ntogou/nova-v2/firmware/nova_live/config.h

#pragma once
#define FW_VERSION "2.9.0"
#define UI_ENGLISH 1
#define UI_TR(tr, en) (UI_ENGLISH ? (en) : (tr))
#define PIN_AMP_R_BCLK 42
#define PIN_AMP_R_LRC   2
#define PIN_AMP_R_DIN  41
#define PIN_AMP_L_BCLK 10
#define PIN_AMP_L_LRC  11
#define PIN_AMP_L_DIN   9
#define PIN_MIC_SCK    12
#define PIN_MIC_WS     13
#define PIN_MIC_SD     14
#define PIN_TFT_BLK     4
#define PIN_TFT_CS      5
#define PIN_TFT_DC      6
#define PIN_TFT_RST     7
#define PIN_TFT_MOSI   15   // modülde "SDA"
#define PIN_TFT_SCK    16   // modülde "SCL"
#define PIN_BAT_ADC     3
#define PIN_FREE_REF   17
#define PIN_BUTTON      0
#define PIN_RGB_LED    48
#define TFT_TAB        INITR_BLACKTAB
#define TFT_ROTATION   1
#define TFT_SPI_HZ     16000000   // elle çekilmiş tellerde güvenli hız; sorun yoksa 27000000 yapılabilir
#define UI_FPS         20
#define MIC_RATE           16000
#define MIC_FRAME_SAMPLES  1280     // 80 ms: modele bu boyda parçalar gider
#define MIC_SHIFT          14
#define MIC_MODE           0
#define MIC_DRIVE          2
#define MIC_TRY_PIN_ORDERS 0
#define MIC_PROBE_SILENCE  0
#define MIC_HPF_HZ         120
#define SPK_RATE           24000
#define SPK_BLOCK          240      // 10 ms
#define SPK_PREBUF_MS      120      // çalmaya başlamadan önce biriken ses
#define SPK_RING_MS        60000    // çalma tamponu (PSRAM'de 2,9 MB)
#define SPK_RING_MS_NOPSRAM 2500
#define DEFAULT_VOLUME     80       // 0-100. %100'de amfi bozuyor (Aşama 1 ölçümü); temiz tavan %80-90
#define SPK_BOOST_DB       10.0f
#define SPK_BOOST_DB_GPTLIVE 14.0f
#define SPK_LIMIT_REL_MS   100.0f   // sınırlayıcının kısılan sesi geri açma süresi
#define SPK_CEILING_DB     -3.0f
#define SPK_HPF_HZ         150.0f   // hoparlörün veremediği alt frekanslar atılır
#define DEFAULT_BRIGHTNESS 80       // 0-100
#define BAT_DIVIDER        2.0f     // 47k/47k
#define BAT_CAL            1.00f
#define BAT_LOW_V          3.20f    // bunun altında 20 sn kalırsa uykuya geçer
#define BAT_VALID_MIN_V    2.50f    // bunun altı "ölçüm yok" sayılır
#define HOSTNAME           "nova"   // ağdaki adı: http://nova.local, Arduino IDE'de "nova at ..."
#define SAFE_MODE_CRASHES  3
#define STATUS_INTERVAL_MS 5000
#define OPENAI_HOST        "api.openai.com"
#define OPENAI_PORT        443
#define GPTLIVE_MODEL      "gpt-live-1"
#define GPTLIVE_VOICE      "marin"
#define GPTLIVE_VOICES "marin", "cedar", "alloy", "ash", "ballad", "coral", "echo", "sage", "shimmer", "verse", \
  "quartz", "ripple", "vesper", "willow", "stone", "gleam", "meridian", "bossa", "tempo", "beacon", "delta", \
  "cinder", "brise", "flitz", "harema", "juni", "nira", "noeul", "nuri", "shida", "sillage"
#define GPTLIVE_BACKEND_MODEL "gpt-6-luna"
#define GPTLIVE_BACKEND_NOTE "Cevabın sesli okunacak: en fazla iki kısa cümle, düz metin, kullanıcının konuştuğu dilde (genelde Türkçe). Liste, madde işareti ya da bağlantı kullanma. Arama gerekiyorsa tek arama yap, sonucu hemen ver."
#define GPTLIVE_BACKEND_TIER   "priority"
#define GPTLIVE_BACKEND_EFFORT "low"
#define GPTLIVE_WEB_SEARCH 1
#define GPTLIVE_END_GAP_MS 550
#define GPTLIVE_AUDIO_RATE 24000
#define GPTLIVE_PREBUF_MS  300
#define GPTLIVE_PREBUF_MAX_MS 650
#define GPTLIVE_NET_GAP_MS 250
#define GPTLIVE_ANSWER_END_MS 1400
#define GPTLIVE_THINK_AFTER_MS 900
#define GPTLIVE_LOG_FIRST_EVENTS 0
#define GPTLIVE_POST_SPEECH_GUARD_MS 100
#define GPTLIVE_OUT_SILENCE_RMS 100
#define GPTLIVE_NOISE_CHECK_MS  3000
#define GPTLIVE_NOISE_MAX_RMS   800
#define GPTLIVE_HISTORY_LINES 16
#define GPTLIVE_HISTORY_TEXT  360
#define GPTLIVE_HISTORY_MAX_AGE_MS (30UL * 60UL * 1000UL)
#define GPTLIVE_USD_PER_MIN 0.05f   // ses katmanının dakika ücreti (11 Ekim 2026 fiyat sayfası)
#define VOICE_SAMPLE_PROMPT "Yeni sesinle kendini iki kısa cümleyle tanıt."
#define MIC_UPLINK_GAIN_Q8 512
#define MIC_ACTIVITY_PEAK  2500
#define LINK_IDLE_SLEEP_MS 25000
#define LINK_SHORT_CLOSE_MS 12000
#define LINK_MAX_QUIET_MS  90000
#define LINK_THINK_MAX_MS  3500
#define LINK_POST_SPEECH_GUARD_MS 350
#define WAKE_DEFAULT_MODE  3      // 0 kapalı, 1 normal, 2 hassas, 3 çok hassas ('n' ile sırayla)
#define WAKE_HOLDOFF_MS    1500
#define ECHO_AEC_MODE       5      // 5 = AEC_MODE_FD_LOW_COST (Aşama 1: %25 işlemci), 6 = FD_HIGH_PERF
#define ECHO_NLP_DEFAULT    0
#define ECHO_FILTER_LEN     4      // ESP-SR'nin önerdiği
#define ECHO_IN_HEADROOM_DB 12
#define ECHO_AEC_PSRAM      1
#define ECHO_ADVANCE        32     // referans, ölçülen gecikmeden 2 ms önce verilir (süzgeç penceresinin içinde kalsın)
#define ECHO_DELAY_MAX      4800   // ölçümde aranan en büyük gecikme (300 ms)
#define ECHO_GATE_MARGIN_DB 8.0f   // Nova konuşurken kapı, ölçülen artık yankının bu kadar üstünde açılır
#define ECHO_GATE_HANG_MS   250    // kapı açıldıktan sonra açık kalma (hece aralarında kesilmesin)
#define ECHO_DUCK_DB        0.0f
#define ECHO_DUCK_HOLD_MS   400
#define ECHO_DUCK_NEAR_DB   4.0f
#define ECHO_DUCK_NEAR_N    3
#define ECHO_LOOKBACK_MS    256
#define ECHO_DEFAULT_ON     0      // ilk açılışta araya girme (sonra 'e' ile değişir, kartta saklanır)
#define GPTLIVE_BARGE_GUARD_MS 1500
#define HANGUP_COMMANDS  "oturumu kapat", "oturumu bitir", "oturumu sonlandir", "konusmayi bitir", "konusmayi kapat", \
                         "konusmayi sonlandir", "gorusmeyi bitir", "gorusmeyi kapat", "gorusmeyi sonlandir", "uyuyabilirsin", "uykuya gec", \
                         "kapat kendini", "kendini kapat", "kapan artik"
#define HANGUP_FAREWELLS "gorusuruz", "gorusmek uzere", "hosca kal", "hoscakal", "iyi geceler", "bay bay", "bye bye", "kendine iyi bak"
#define NOVA_FAREWELLS     "gorusuruz"
#define NOVA_BYE_MAX_WORDS 5
#define LINK_BYE_WAIT_MS   4000
#define LINK_BACKEND_WAIT_MS 60000
#define WS_RX_BYTES        (256 * 1024)
#define WS_TX_BYTES        (48 * 1024)   // GPT-Live'ın açılış mesajı kişilik + hafıza + konuşma geçmişi + araçları taşır
#define HAFIZA_MAX_NOT     60       // kalıcı not sayısı (her oturumda talimata eklenir)
#define HAFIZA_METIN       180      // bir notun en uzun hali (bayt; Türkçe harfler iki bayt)
#define ZAMANLAYICI_MAX    8
#define YEREL_SAAT_FARKI   10800    // Türkiye UTC+3 (yaz saati yok)
#define HAVA_ACIK          1
#define HAVA_YER           "İzmir"
#define HAVA_ENLEM         38.42f
#define HAVA_BOYLAM        27.14f
#define HAVA_YENILE_MS     (60UL * 60UL * 1000UL)   // bu kadar eskiyince yenilenir
#define HAVA_TEKRAR_MS     (10UL * 60UL * 1000UL)   // alınamazsa bu kadar sonra yeniden denenir
#define HAVA_ESKI_MS       (6UL * 60UL * 60UL * 1000UL)   // bundan eskisi modele verilmez
#define GUNDEM_ACIK        1
#define GUNDEM_SAATLER     {8, 13, 19}
#define GUNDEM_MAX_ARAMA   3
#define GUNDEM_ESKI_SAAT   14                              // bundan eskisi modele verilmez
#define GUNDEM_CAP         1600                            // özetin en çok bayt sayısı (NVS'de de saklanır)
#define GUNDEM_TEKRAR_MS   (15UL * 60UL * 1000UL)          // ağ hatasında yeniden deneme
#define GUNDEM_YOKLA_MS    10000                           // sonucu yoklama aralığı
#define GUNDEM_YOKLA_MAX   24                              // ~4 dk sonra vazgeçilir
#define BOSTA_KIS_MS       30000
#define BOSTA_PARLAKLIK    3        // % (0 = ekran kapalı)
#define BOSTA_WIFI_UYKU    1
#define SESLI_SES_ADIM     20
