ntogou/nova-v2/firmware/nova_live/yazitipleri.h

// Otomatik üretildi: nova_tools/yazitipi_uret.py (Chakra Petch, SIL Open Font License 1.1)
// 4 bit kenar yumuşatmalı bitmap yazı tipleri. Elle düzenleme; betiği yeniden çalıştır.
#pragma once
#include <stdint.h>

struct NGlif { uint16_t ofs; uint8_t w, h, adv8; int8_t xo, yo; };   // adv8: ilerleme, 1/8 piksel
struct NFont { const uint8_t *bmp; const NGlif *g; uint16_t ilk, son; uint8_t satir, ust; };

static const uint8_t F_SAAT_bmp[] = {
  0xCC,0xCC,0xCC,0xCC,0xCC,0xCC,0xCF,0xFF,0xFF,0xFF,0xFF,0xFF,0xFF,0xFF,0xFF,0xFF,0xFF,0xFF,0xFF,0xFF,0xFF,0xFF,0xFF,0xFF,
  0xFF,0xFF,0x2C,0xFF,0xD2,0xDF,0xFF,0xFD,0xFF,0xFF,0xFF,0xDF,0xFF,0xFD,0x2C,0xFF,0xD2,0x00,0x00,0x00,0x00,0x00,0x00,0x00,
  0x0C,0xFF,0xFD,0x00,0x00,0x00,0x00,0x00,0x00,0x00,0x6F,0xFF,0xF4,0x00,0x00,0x00,0x00,0x00,0x00,0x01,0xEF,0xFF,0xB0,0x00,
  0x00,0x00,0x00,0x00,0x00,0x07,0xFF,0xFF,0x30,0x00,0x00,0x00,0x00,0x00,0x00,0x1E,0xFF,0xFA,0x00,0x00,0x00,0x00,0x00,0x00,
  0x00,0x9F,0xFF,0xF2,0x00,0x00,0x00,0x00,0x00,0x00,0x02,0xFF,0xFF,0x80,0x00,0x00,0x00,0x00,0x00,0x00,0x0B,0xFF,0xFE,0x10,
  0x00,0x00,0x00,0x00,0x00,0x00,0x4F,0xFF,0xF7,0x00,0x00,0x00,0x00,0x00,0x00,0x00,0xCF,0xFF,0xD0,0x00,0x00,0x00,0x00,0x00,
  0x00,0x05,0xFF,0xFF,0x50,0x00,0x00,0x00,0x00,0x00,0x00,0x0D,0xFF,0xFC,0x00,0x00,0x00,0x00,0x00,0x00,0x00,0x7F,0xFF,0xF4,
  0x00,0x00,0x00,0x00,0x00,0x00,0x01,0xEF,0xFF,0xA0,0x00,0x00,0x00,0x00,0x00,0x00,0x08,0xFF,0xFF,0x20,0x00,0x00,0x00,0x00,
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
  {431,6,6,47,0,-6},
  {449,5,7,43,0,-7},
  {467,8,8,65,0,-7},
  {499,6,7,50,0,-7},
  {520,6,7,52,0,-7},
  {541,6,7,50,0,-7},
  {562,6,7,53,0,-7},
  {583,6,7,47,0,-7},
  {604,6,7,44,0,-7},
  {625,6,7,52,0,-7},
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
};
static const NFont F_KUCUK = {F_KUCUK_bmp, F_KUCUK_g, 0x20, 0x93, 14, 10};
