ntogou/nova-v2/firmware/tests/nova_live_masaustu/arac_test.cpp

// Masaüstü testi: hafıza (notlar, zamanlayıcılar, kayıt), cihaz araçları ve sesle ses komutu.
#include "hafiza.h"
#include "araclar.h"
#include "hava.h"
#include "notcikar.h"
#include "gundem.h"
#include "agistek.h"
#include "config.h"
#include "src/ArduinoJson-v7.4.2.h"
#include <cstdio>
#include <cstring>
#include <string>

static int fails = 0;
#define CHECK(c, ...) do { if (!(c)) { fails++; printf("  !! BASARISIZ (%s:%d): ", __FILE__, __LINE__); printf(__VA_ARGS__); printf("\n"); } } while (0)

static std::string depoIcerik;
static int yazmalar = 0;
static bool depoOku(char *buf, size_t cap, size_t *len) {
  if (depoIcerik.empty() || depoIcerik.size() > cap) return false;
  memcpy(buf, depoIcerik.data(), depoIcerik.size());
  *len = depoIcerik.size();
  return true;
}
static bool depoYaz(const char *buf, size_t len) { depoIcerik.assign(buf, len); yazmalar++; return true; }

// Sahte cihaz
static int ses = 80, parlak = 80;
static int64_t simdiE = 0;
static uint32_t msNow = 100000;
static std::string sonAyar;
static int fSes() { return ses; }
static void fSesAyarla(int v) { ses = v; }
static int fParlak() { return parlak; }
static void fParlakAyarla(int v) { parlak = v; }
static bool fAyar(const char *ad, const char *d, char *msg, size_t cap) {
  sonAyar = std::string(ad) + "=" + d;
  snprintf(msg, cap, "ayar %s = %s", ad, d);
  return true;
}
static void fDurum(char *o, size_t c) { snprintf(o, c, "pil %%62"); }
static int64_t fSimdi() { return simdiE; }
static uint32_t fMs() { return msNow; }

static std::string arac(const char *ad, const char *args) {
  static char out[1024];
  out[0] = 0;
  aracCalistir(ad, args, out, sizeof(out));
  return out;
}
static bool has(const std::string &s, const char *k) { return s.find(k) != std::string::npos; }

int main() {
  hafiza::Depo d;
  d.oku = depoOku;
  d.yaz = depoYaz;
  CHECK(hafiza::begin(d, YEREL_SAAT_FARKI), "begin");
  AracOrtam o;
  o.ses = fSes; o.sesAyarla = fSesAyarla; o.parlaklik = fParlak; o.parlaklikAyarla = fParlakAyarla;
  o.ayar = fAyar; o.durum = fDurum; o.simdi = fSimdi; o.ms = fMs;
  aracBegin(o);
  // 18.10.2026 14:30 Türkiye = 11:30 UTC
  simdiE = hafiza::yerelEpoch(2026, 10, 18, 14, 30);
  {
    int y, m, dd, h, mi, wd;
    hafiza::yerelTakvim(simdiE, &y, &m, &dd, &h, &mi, &wd);
    CHECK(y == 2026 && m == 10 && dd == 18 && h == 14 && mi == 30 && wd == 0, "takvim %d-%d-%d %d:%d gun %d", y, m, dd, h, mi, wd);
    CHECK(simdiE == 1792323000LL, "epoch %lld", (long long)simdiE);     // 2026-10-18T11:30:00Z
  }

  printf("== 1) hafıza: ekle, aynısı tekrar eklenmez, prompt bloğu\n");
  std::string r = arac("remember", "{\"text\":\"Kullanıcının kedisinin adı Pamuk.\",\"source\":\"user_asked\"}");
  CHECK(has(r, "kaydedildi (#1)"), "%s", r.c_str());
  r = arac("remember", "{\"text\":\"kullanıcının kedisinin adı pamuk\",\"source\":\"own_initiative\"}");
  CHECK(has(r, "zaten kayıtlı"), "%s", r.c_str());
  r = arac("remember", "{\"text\":\"Çayı şekersiz içer.\",\"source\":\"own_initiative\"}");
  CHECK(has(r, "#2"), "%s", r.c_str());
  r = arac("remember", "{\"text\":\"Kız kardeşinin adı Ela.\",\"source\":\"user_confirmed\"}");
  CHECK(hafiza::notSayisi() == 3, "not sayisi %d", hafiza::notSayisi());
  char blok[2048];
  hafiza::promptaYaz(blok, sizeof(blok));
  CHECK(has(blok, "- (18.10) Kullanıcının kedisinin adı Pamuk.") && has(blok, "Çayı şekersiz"), "%s", blok);
  char liste[2048];
  hafiza::listele(liste, sizeof(liste));
  CHECK(has(liste, "#2 (18.10, Nova) Çayı şekersiz içer.") && has(liste, "onayladın"), "%s", liste);
  printf("%s", liste);

  printf("== 2) kayıt ve yeniden yükleme\n");
  CHECK(hafiza::degisti() && hafiza::kaydet() && !hafiza::degisti() && yazmalar == 1, "kaydet");
  CHECK(hafiza::kaydet() && yazmalar == 1, "degismeden yazildi");
  CHECK(hafiza::begin(d, YEREL_SAAT_FARKI) && hafiza::notSayisi() == 3, "yeniden yukleme %d", hafiza::notSayisi());
  r = arac("remember", "{\"text\":\"Bir not daha\",\"source\":\"user_asked\"}");
  CHECK(has(r, "#4"), "numara surmedi: %s", r.c_str());
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
